BANIUCZYN/3-phase-motor-current-measurement-eval-board/hardware/ECAD_board_views/3D_top_view.png

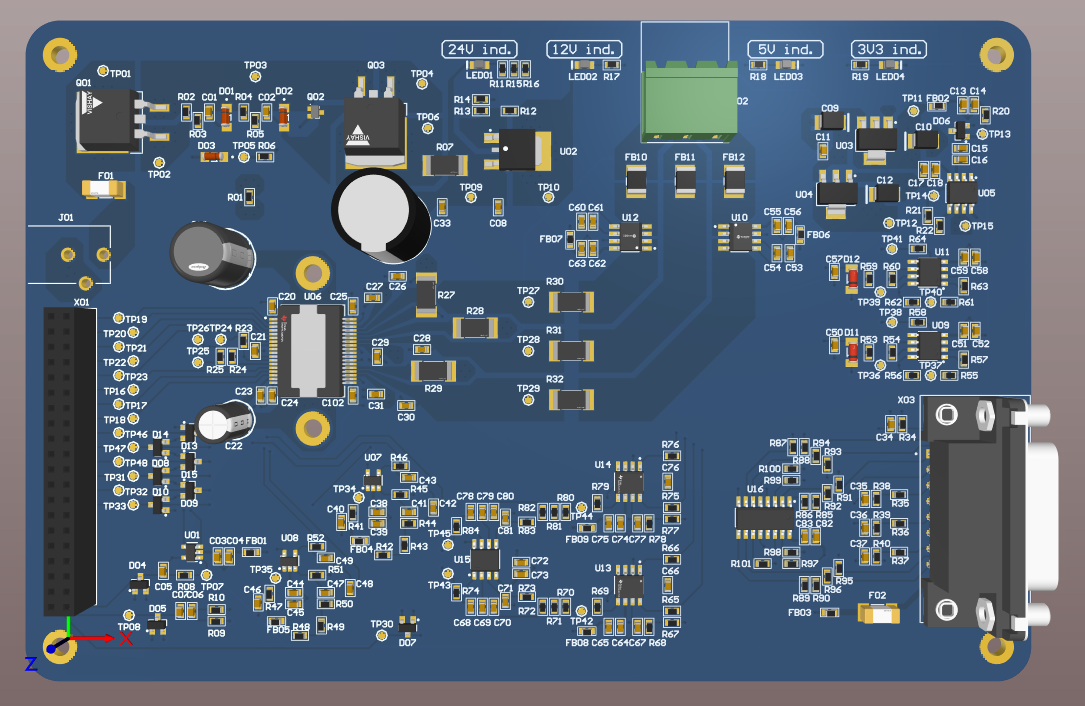
hardware/ECAD_board_views/3D_top_view.png
