BANIUCZYN/3-phase-motor-current-measurement-eval-board/hardware/ECAD_board_views/L1.png

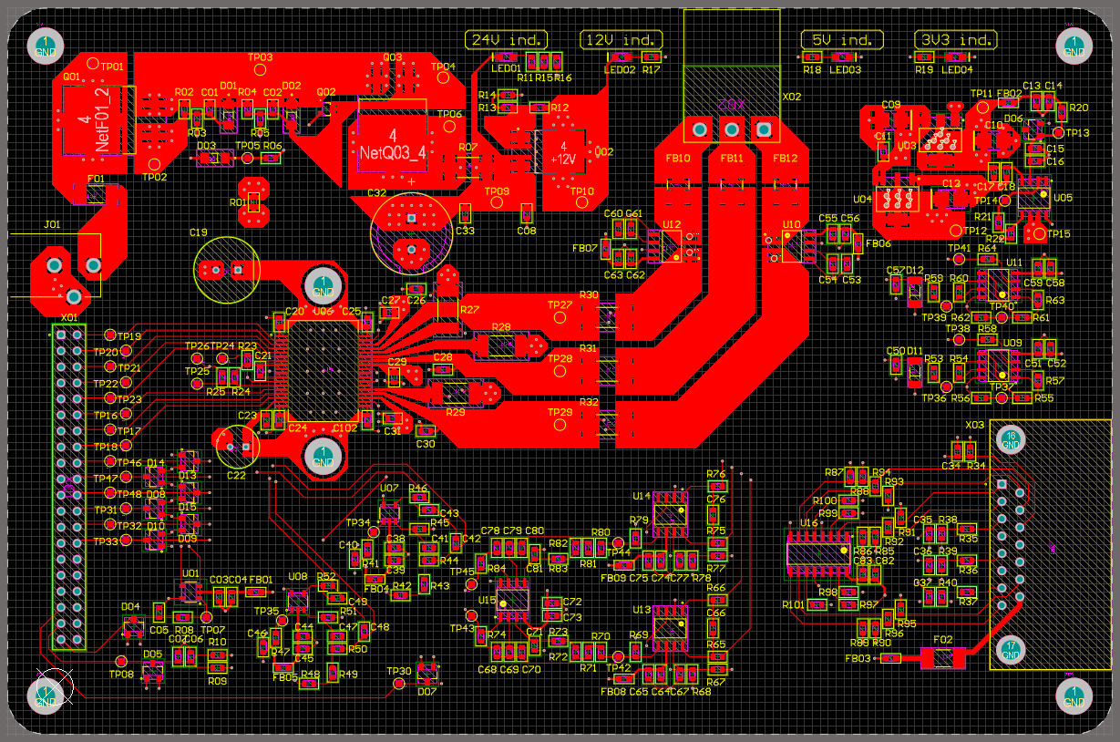
hardware/ECAD_board_views/L1.png
