BANIUCZYN/3-phase-motor-current-measurement-eval-board/other/RPP_circuit_LTspice_simulation.png

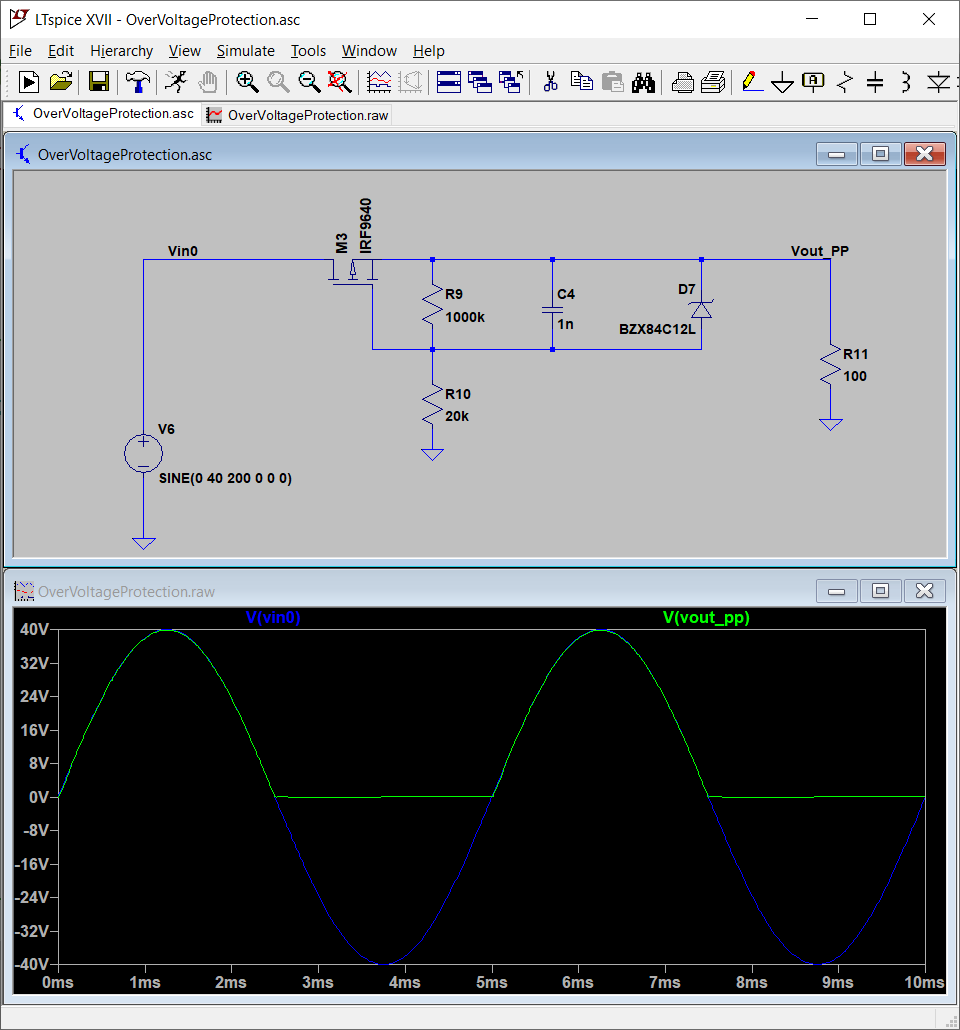
other/RPP_circuit_LTspice_simulation.png
