BANIUCZYN/3-phase-motor-current-measurement-eval-board/hardware/Power_stage_electrical_diagram_PL.pdf

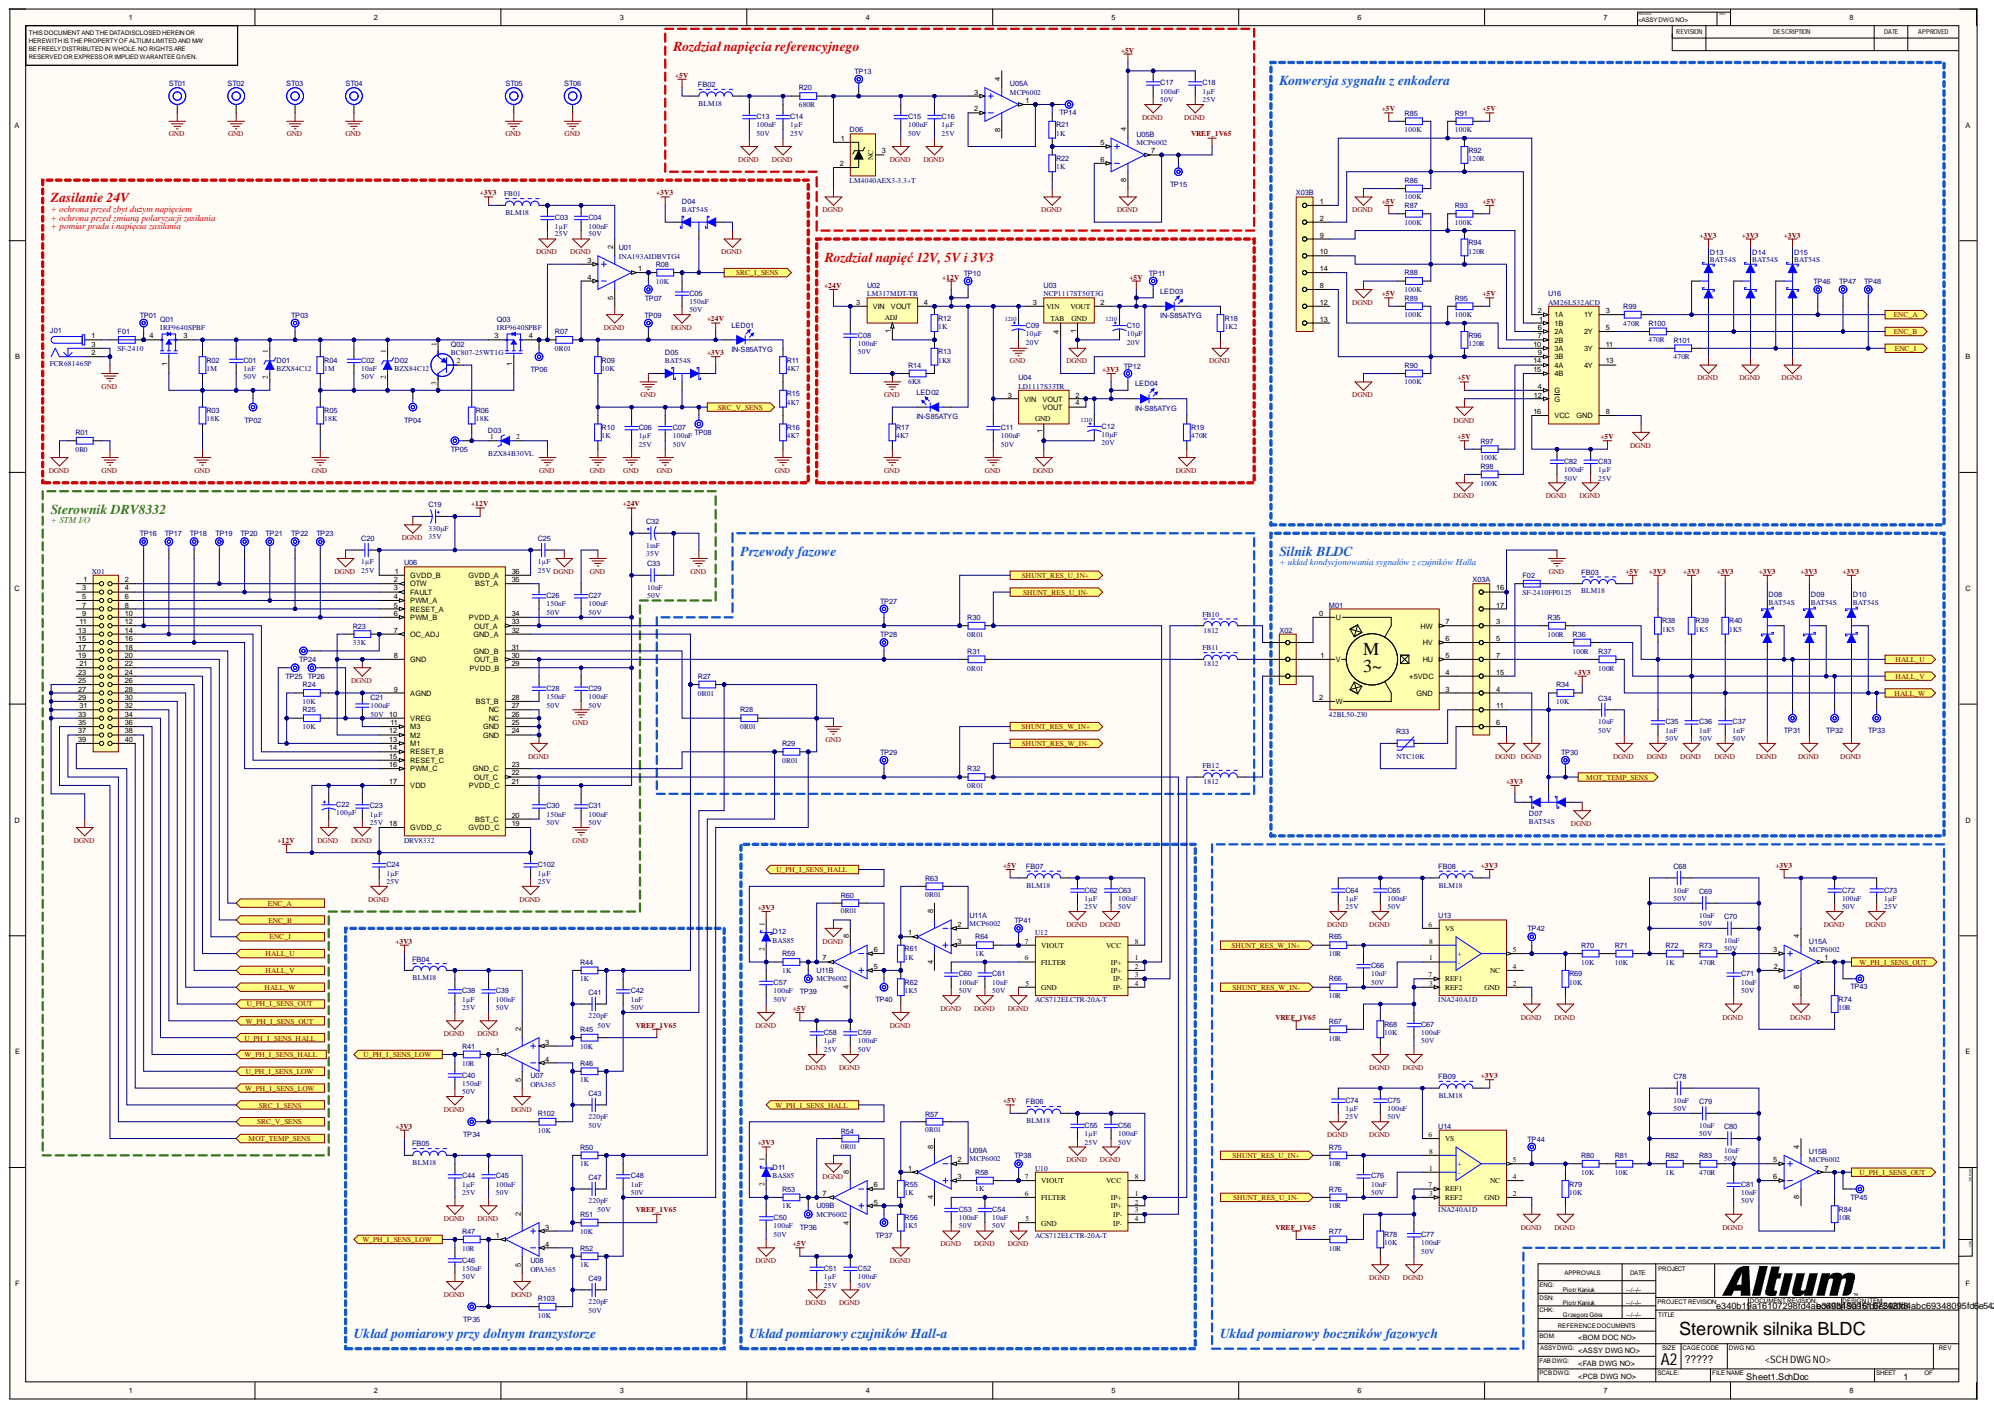
[picture p16: page 1]

1 | 2 | 3 | 4 | 5 | 6 | 7 | DWG NO: <ASSY DWG NO> | REV: | 8

THIS DOCUMENT AND THE DATADISCLOSED HEREIN OR HEREWITH ISTHE PROPERTYOF ALTIUM LIMITED AND MAY BEFREELY DISTRIBUTED IN WHOLE. NO RIGHTSARE RESERVED OR EXPRESSOR IMPLIED WARANTEEGIVEN. | | REVISION | DESCRIPTION | DATE | APPROVED

6 | DGND

Zasilanie 24V + ochrona przed zbyt dużym napięciem

+ ochrona przed zmianą polaryzacji zasilania
+ pomiar pradu i napięcia zasilania

8 | 100K
12 | +5V DGND R89 R95

R96 | 2B 7
120R

Silnik BLDC + układ kondycjonowania sygnałów z czujników Halla

PWM_C 16

VDD 17 | FB08

ENG: Piotr Kaniuk | --/--/--

DSN: Piotr Kaniuk | --/--/-- | PROJECT REVISION: | DOCUMENT REVISION: | DESIGN ITEM:

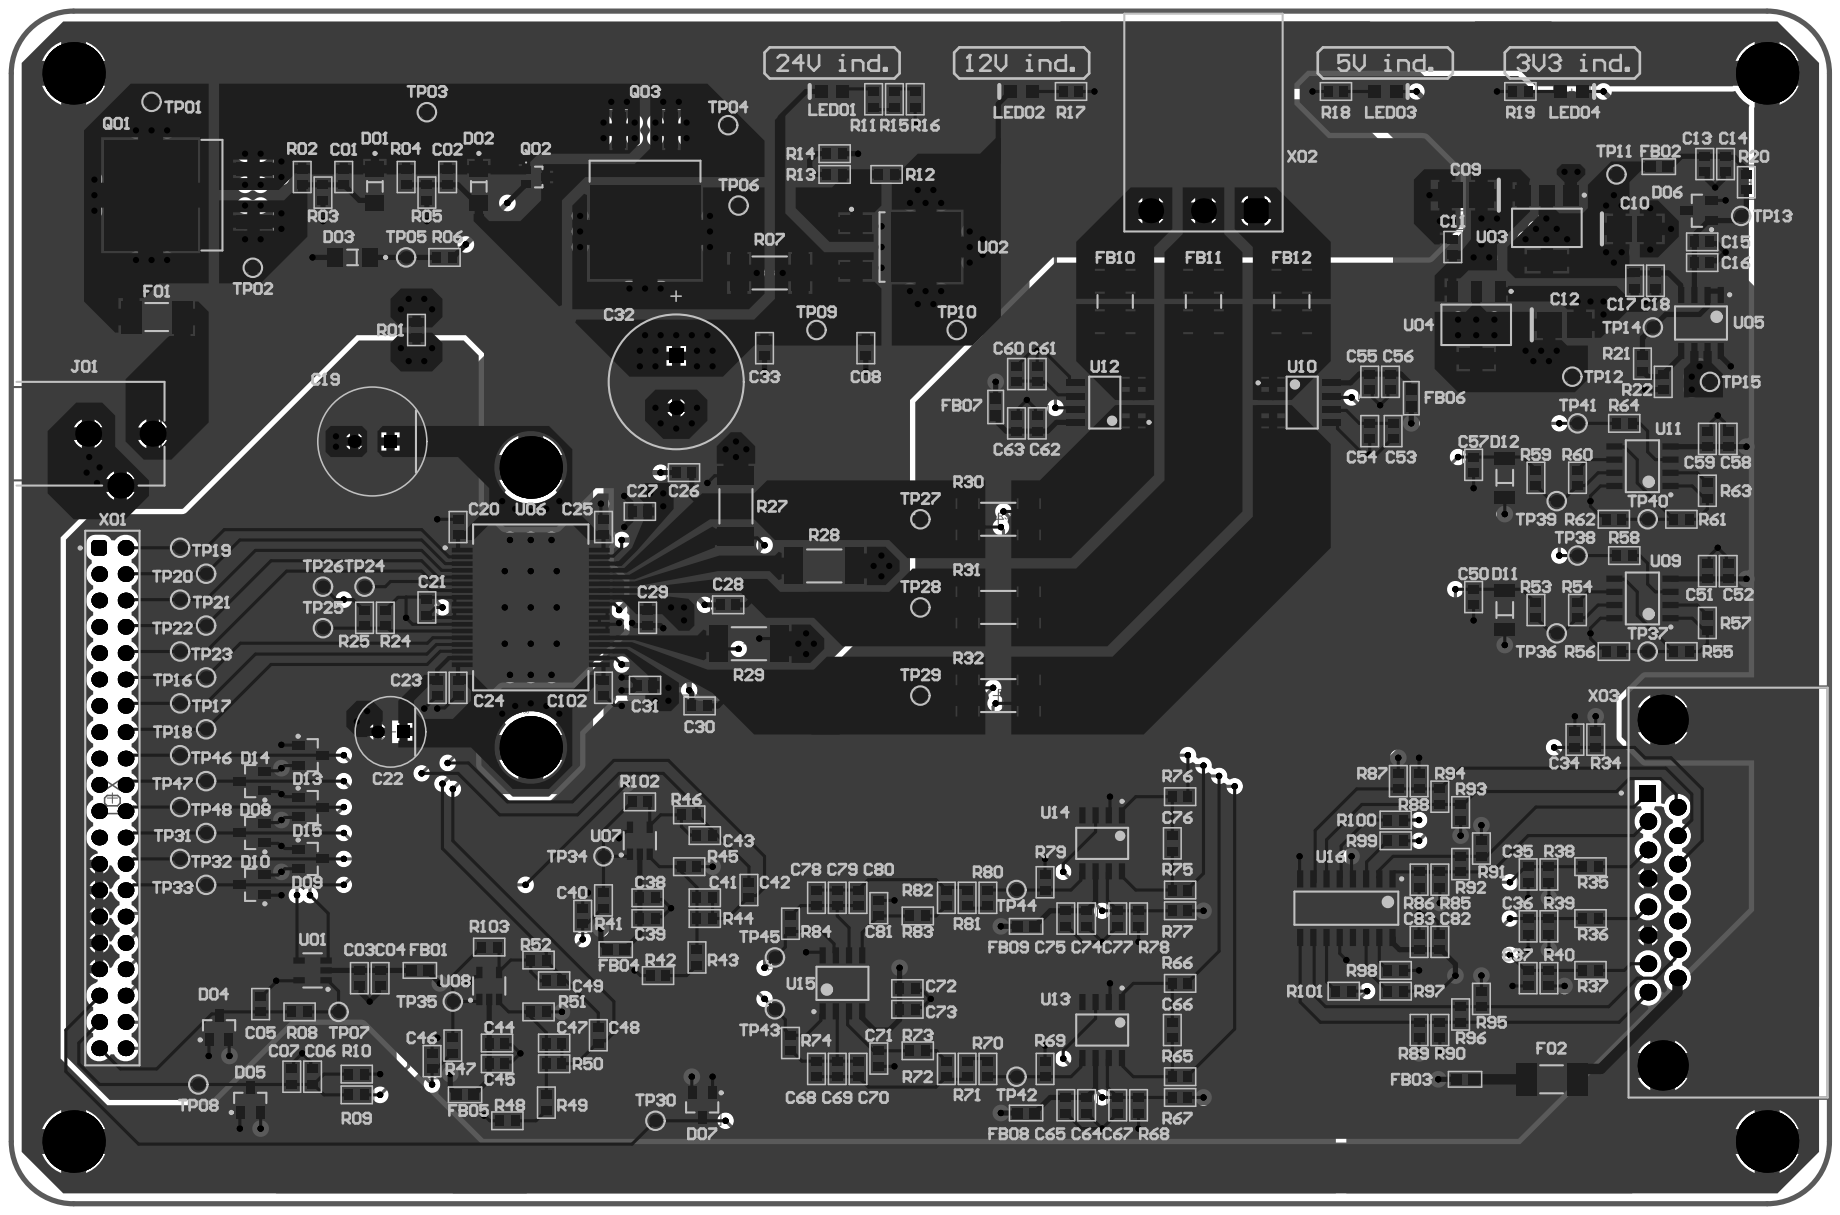
[picture p17: page 2]
