BANIUCZYN/3-phase-motor-current-measurement-eval-board/other/OVP_circuit_test.png

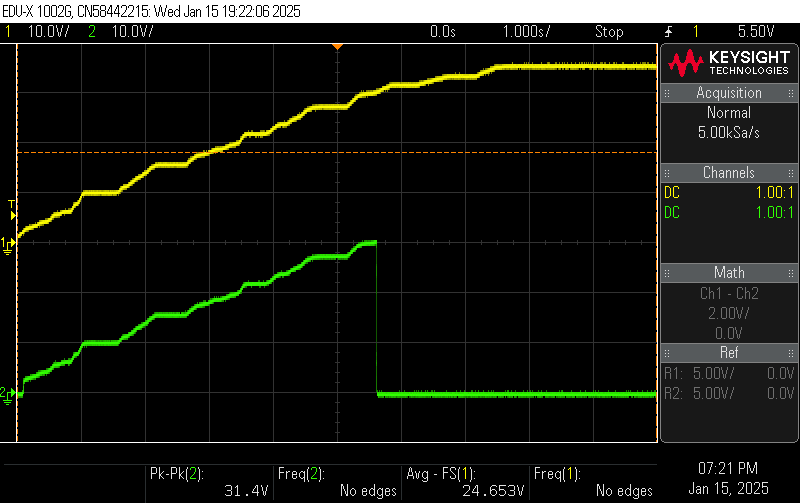
other/OVP_circuit_test.png
