BANIUCZYN/3-phase-motor-current-measurement-eval-board/software/firmware/main.c

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
/* Includes ------------------------------------------------------------------*/
#include "main.h"

/* USER CODE BEGIN Includes */
#include <stdio.h>
/* USER CODE END Includes */

ADC_HandleTypeDef hadc1;
DMA_HandleTypeDef hdma_adc1;

TIM_HandleTypeDef htim2;
TIM_HandleTypeDef htim4;

UART_HandleTypeDef huart3;
DMA_HandleTypeDef hdma_usart3_tx;

void SystemClock_Config(void);
static void MX_GPIO_Init(void);
static void MX_DMA_Init(void);
static void MX_USART3_UART_Init(void);
static void MX_TIM2_Init(void);
static void MX_TIM4_Init(void);
static void MX_ADC1_Init(void);
/* USER CODE BEGIN PFP */
uint16_t adc_pot;
/* USER CODE END PFP */

/* USER CODE BEGIN 0 */
void delay(int32_t i_max);
int _write(int fd, char* ptr, int len);
/* USER CODE END 0 */

/**
  * @brief  The application entry point.
  * @retval int
  */
int main(void)
{

  /* MCU Configuration--------------------------------------------------------*/

  /* Reset of all peripherals, Initializes the Flash interface and the Systick. */
  HAL_Init();

  /* USER CODE BEGIN Init */


  // *** TIM2 - Motor PWM
  // --------------------------------------------------
  __HAL_RCC_TIM2_CLK_ENABLE();
  // --------------------------------------------------

  // *** TIM4 - Encoder Position
  // --------------------------------------------------
  __HAL_RCC_TIM4_CLK_ENABLE();
  // --------------------------------------------------

  // *** TIM4 - Encoder Position
  // --------------------------------------------------
  __HAL_RCC_TIM4_CLK_ENABLE();
  // --------------------------------------------------


  /* USER CODE END Init */

  /* Configure the system clock */
  SystemClock_Config();

  /* Initialize all configured peripherals */
  MX_GPIO_Init();
  MX_DMA_Init();
  MX_USART3_UART_Init();
  MX_TIM2_Init();
  MX_TIM4_Init();
  MX_ADC1_Init();
  /* USER CODE BEGIN 2 */

  // *** TIM2 - PWM
  // --------------------------------------------------
  HAL_TIM_PWM_Start(&htim2, TIM_CHANNEL_4);
  HAL_TIM_Base_Start_IT(&htim2);
  // --------------------------------------------------



  // *** ADC - POT
  // -----------------------------------------------------------------
  HAL_ADC_Start_DMA(&hadc1, &adc_pot, 1);
  // -----------------------------------------------------------------




  // *** TIM4 - ENCO
  // -----------------------------------------------------------------
  HAL_TIM_Encoder_Start(&htim4, TIM_CHANNEL_1);
  HAL_TIM_Encoder_Start(&htim4, TIM_CHANNEL_2);
  // -----------------------------------------------------------------


  /* USER CODE END 2 */

  /* Infinite loop */
  /* USER CODE BEGIN WHILE */
  while (1)
  {
	  // GPIO Output
	  // -------------------------------------------------------------
	  /*
	  delay(1000000);
	  HAL_GPIO_WritePin(GPIOG, GPIO_PIN_13, GPIO_PIN_SET);
	  delay(1000000);
	  HAL_GPIO_WritePin(GPIOG, GPIO_PIN_13, GPIO_PIN_RESET);
	  */
	  // -------------------------------------------------------------





	  // GPIO Input
	  // -------------------------------------------------------------
	  /*
	  if(HAL_GPIO_ReadPin(GPIOA, GPIO_PIN_0) == GPIO_PIN_RESET)
		  HAL_GPIO_WritePin(GPIOG, GPIO_PIN_14, GPIO_PIN_RESET);
	  else
		  HAL_GPIO_WritePin(GPIOG, GPIO_PIN_14, GPIO_PIN_SET);
		*/
	  // -------------------------------------------------------------



	  // USART3/DMA/printf
	  // -------------------------------------------------------------
	  /*
	  printf("STM32!\r\n");
	  delay(10000000);
	  */
	  // -------------------------------------------------------------


	  // ** TIM - PWM
	  TIM2->CCR4 = 750;

	  printf("EncoPos: %i; ADC: %i\r\n", TIM4->CNT, adc_pot);
	  delay(10000000);


    /* USER CODE END WHILE */

    /* USER CODE BEGIN 3 */
  }
  /* USER CODE END 3 */
}

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
/* USER CODE BEGIN 4 */

void delay(int32_t i_max)
{
	volatile int32_t i;

	for(i = 0; i < i_max; i++);
}

int _write(int fd, char* ptr, int len)
{
    HAL_UART_Transmit_DMA(&huart3, (uint8_t *) ptr, len);
	//HAL_UART_Transmit(&huart3, (uint8_t *) ptr, len, 10000);
    return len;
}

/* USER CODE END 4 */
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
