BANIUCZYN/3-phase-motor-current-measurement-eval-board/software/firmware/Control_software.ioc

Mcu.UserName=STM32F429ZITx
PA0/WKUP.Signal=GPIO_Input
PA3.Signal=S_TIM2_CH4
PB1.Signal=ADCx_IN9
PB10.Signal=USART3_TX
PB11.Signal=USART3_RX
PD12.Signal=S_TIM4_CH1
PD13.Signal=S_TIM4_CH2
PG13.Signal=GPIO_Output
PG14.Signal=GPIO_Output
PH0/OSC_IN.Signal=RCC_OSC_IN
PH1/OSC_OUT.Signal=RCC_OSC_OUT
