BANIUCZYN/3-phase-motor-current-measurement-eval-board/(commit log)

2026-10-15 Rename Power stage electrical diagram.pdf to Power_stage_electrical_diagram_PL.pdf
2026-10-15 Power stage electrical diagram upload
