BANIUCZYN/3-phase-motor-current-measurement-eval-board/(notices)

Notices in the files:
software/firmware/main.c:
Copyright (c) 2024 STMicroelectronics.
All rights reserved.
This software is licensed under terms that can be found in the LICENSE file
