BANIUCZYN/3-phase-motor-current-measurement-eval-board/images/Test_bench.jpg

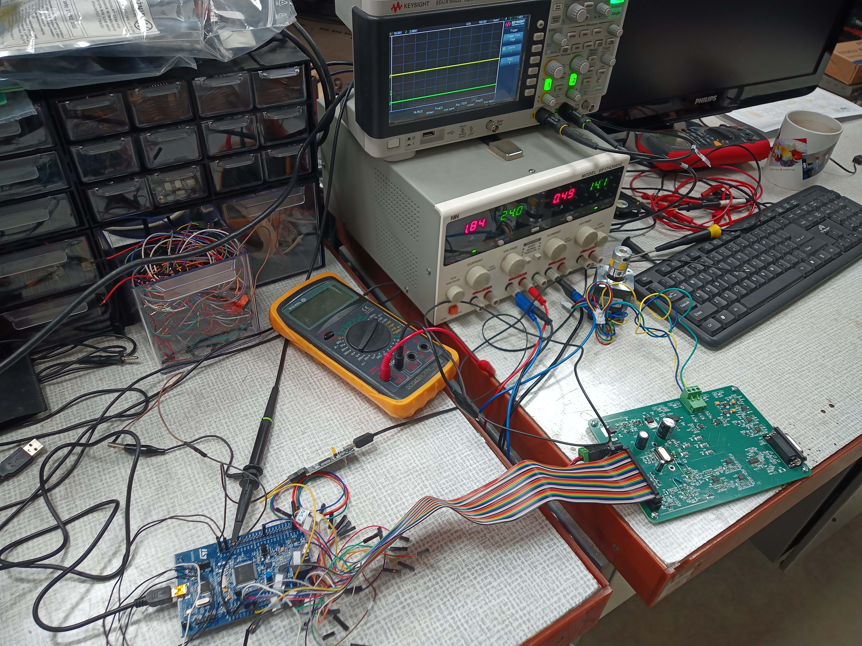
[picture p5: test_bench/Test_bench.jpg]
images/Test_bench.jpg
